danielftsilva/HC-05-Analog-Clock/Code.png

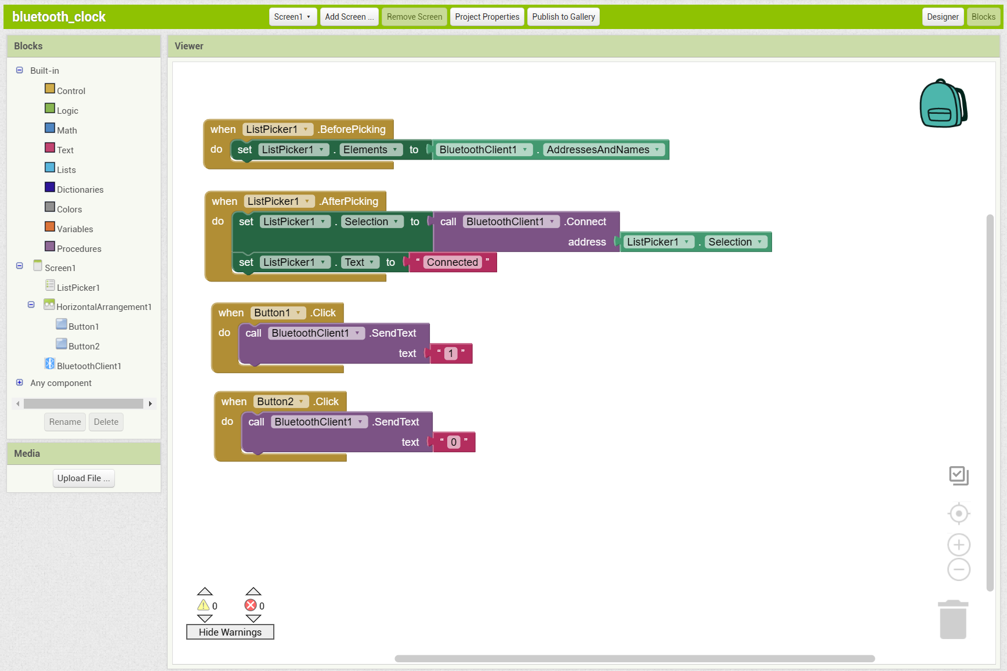
Code.png
