danielftsilva/HC-05-Analog-Clock/GUI.png

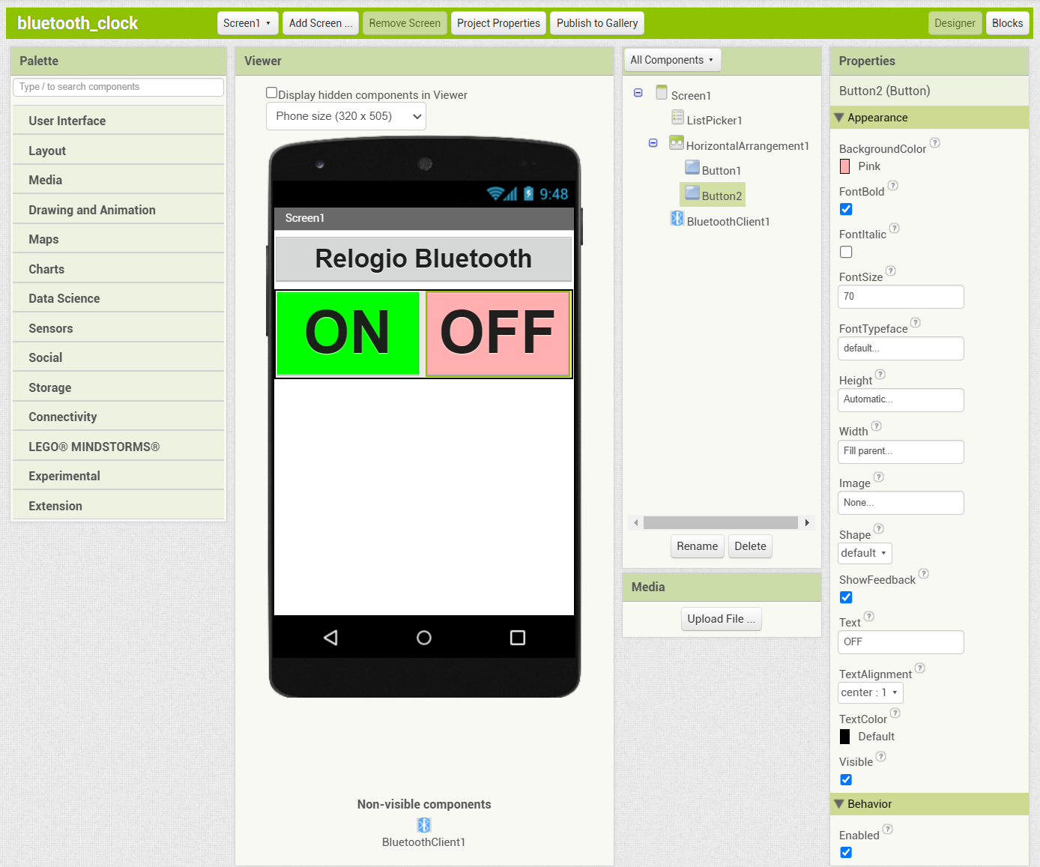
GUI.png
