danielftsilva/HC-05-Analog-Clock/Schematic_UNO.png

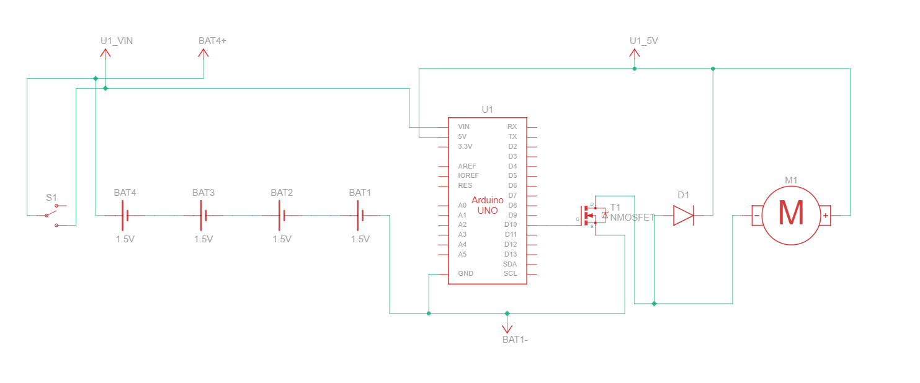
Schematic_UNO.png
