danielftsilva/HC-05-Analog-Clock/Assembly and Tests/Clock_size.jpg

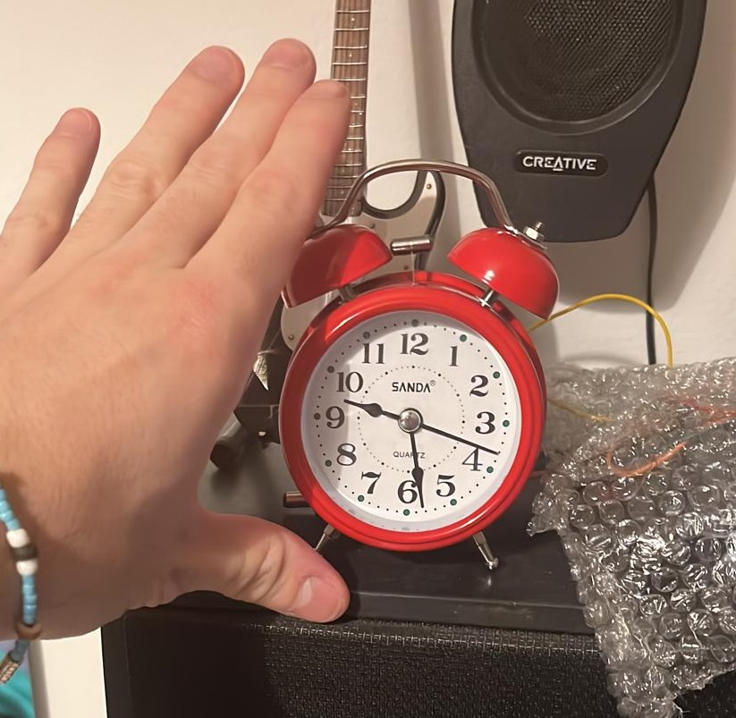
Assembly and Tests/Clock_size.jpg
