danielftsilva/HC-05-Analog-Clock/Assembly and Tests/HC-05_and_FET.jpg

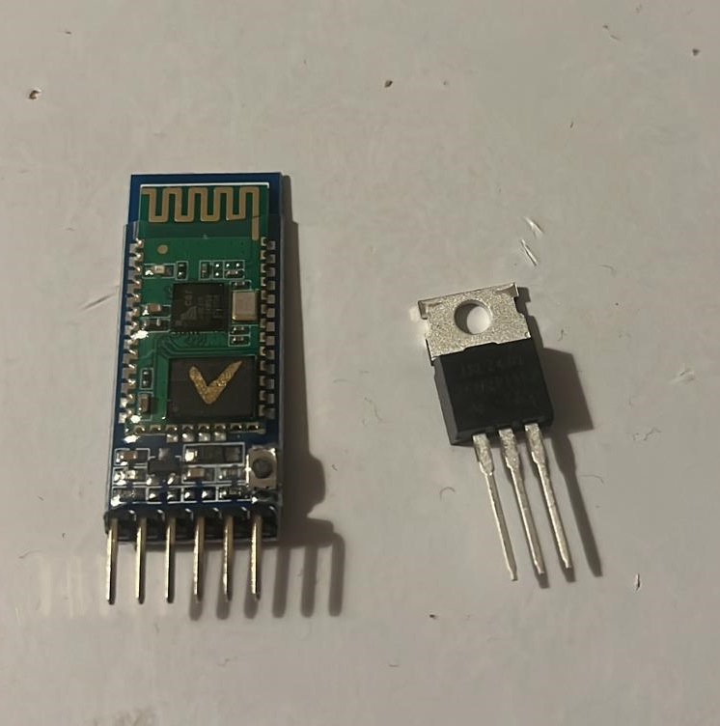
Assembly and Tests/HC-05_and_FET.jpg
