danielftsilva/HC-05-Analog-Clock/Assembly and Tests/Motor_and_switch.jpeg

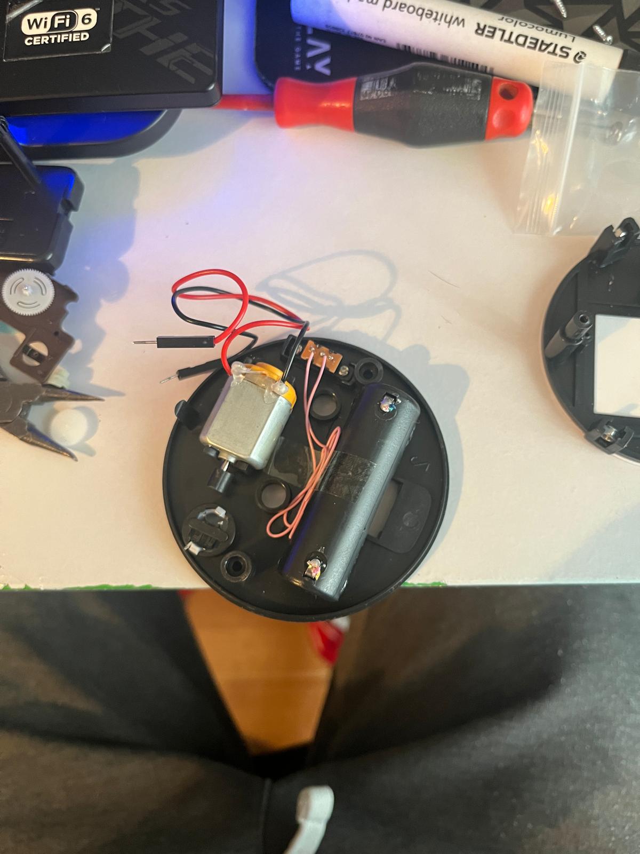
Assembly and Tests/Motor_and_switch.jpeg
