danielftsilva/HC-05-Analog-Clock/Assembly and Tests/Motors_1.jpeg

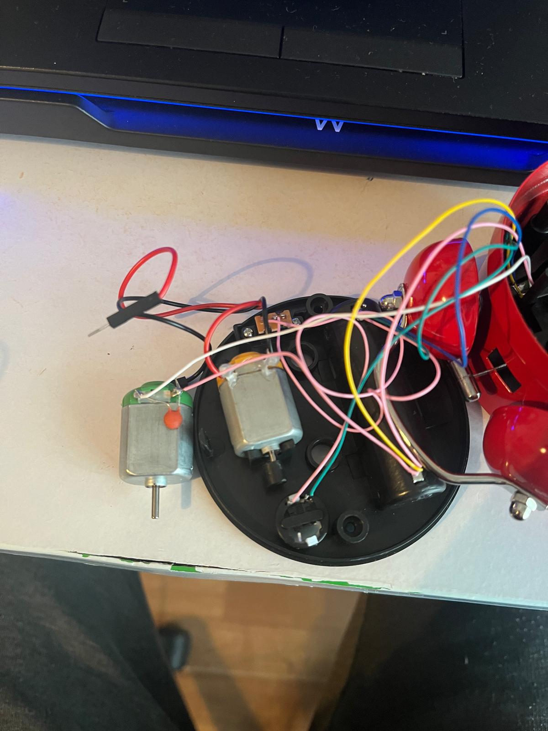
Assembly and Tests/Motors_1.jpeg
