danielftsilva/HC-05-Analog-Clock/Assembly and Tests/Switch_1.jpg

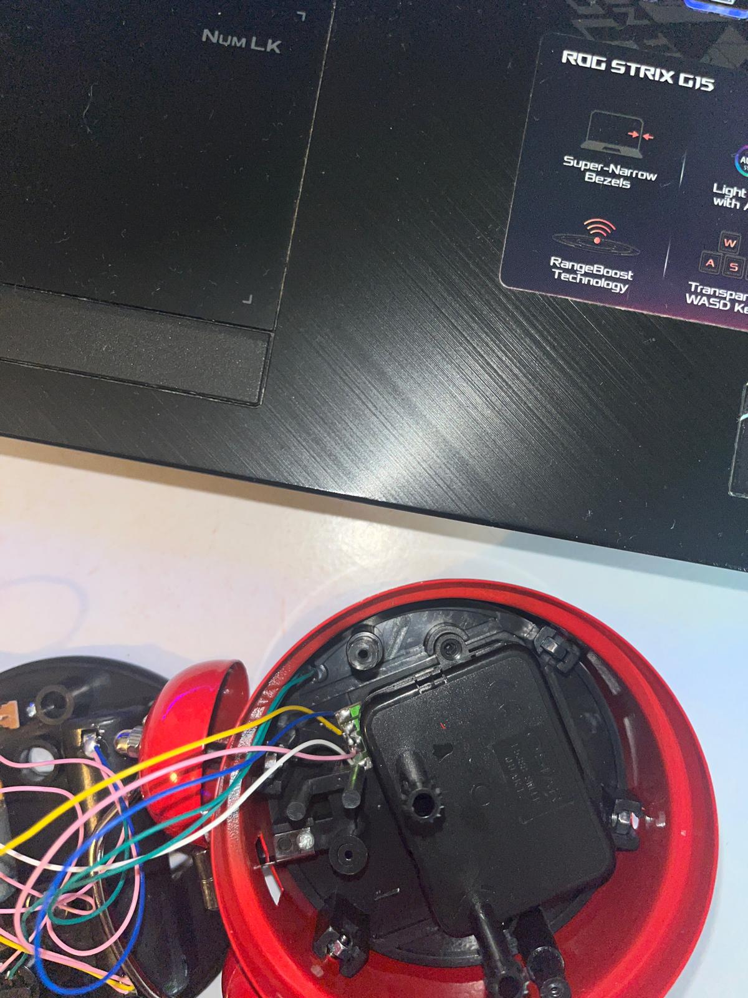
Assembly and Tests/Switch_1.jpg
