danielftsilva/HC-05-Analog-Clock/Assembly and Tests/Taking_it_apart.jpeg

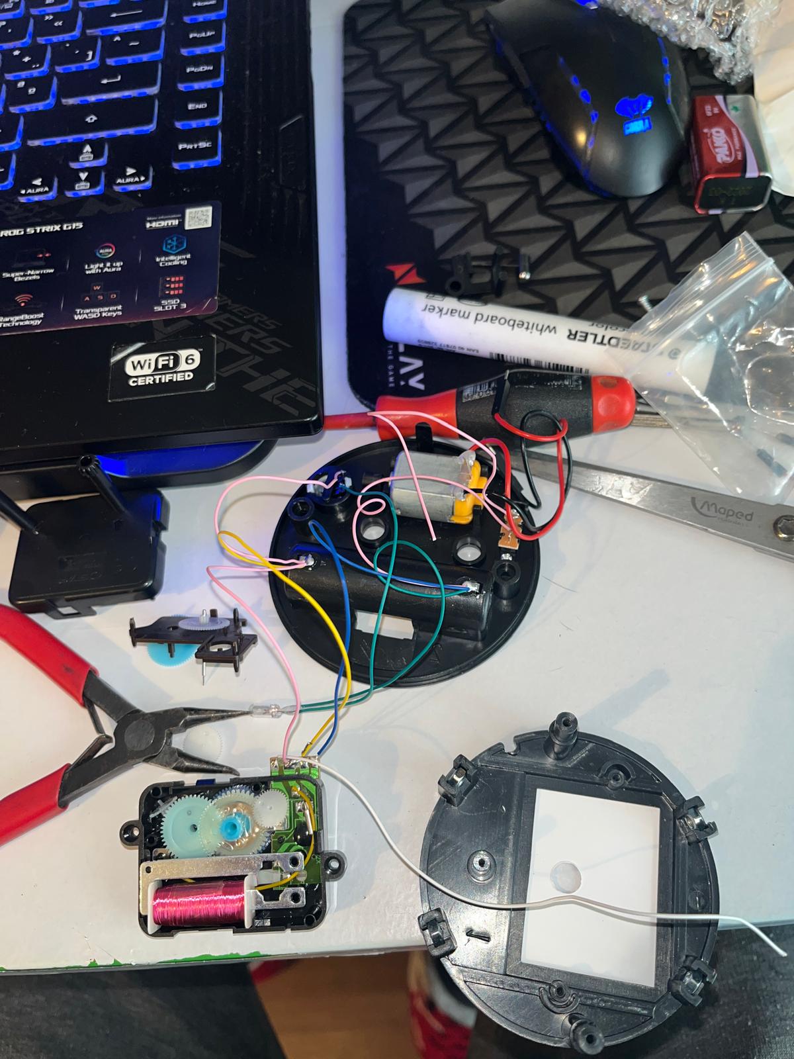
Assembly and Tests/Taking_it_apart.jpeg
